syahrilTGR/KatroKit_esp32/image/fisik_loadCell&HCSR.jpeg

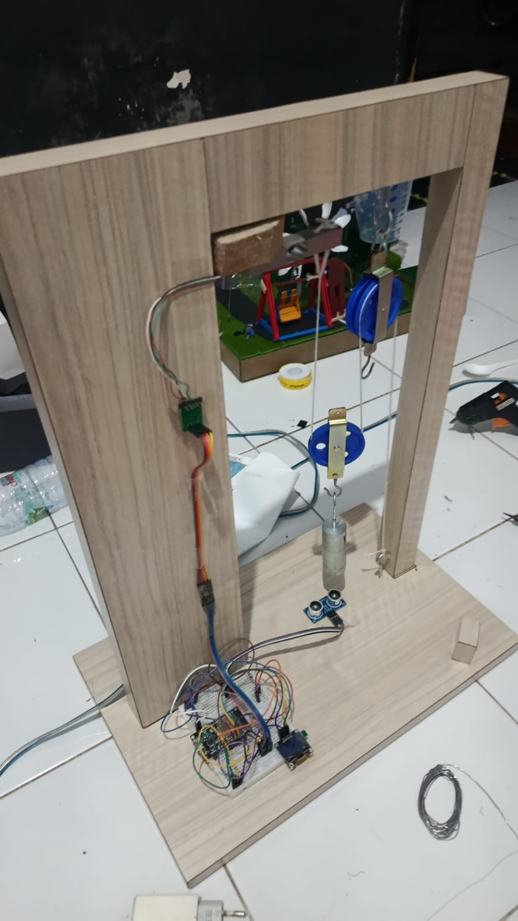
image/fisik_loadCell&HCSR.jpeg
