syahrilTGR/KatroKit_esp32/image/loadCell&HCSR.jpeg

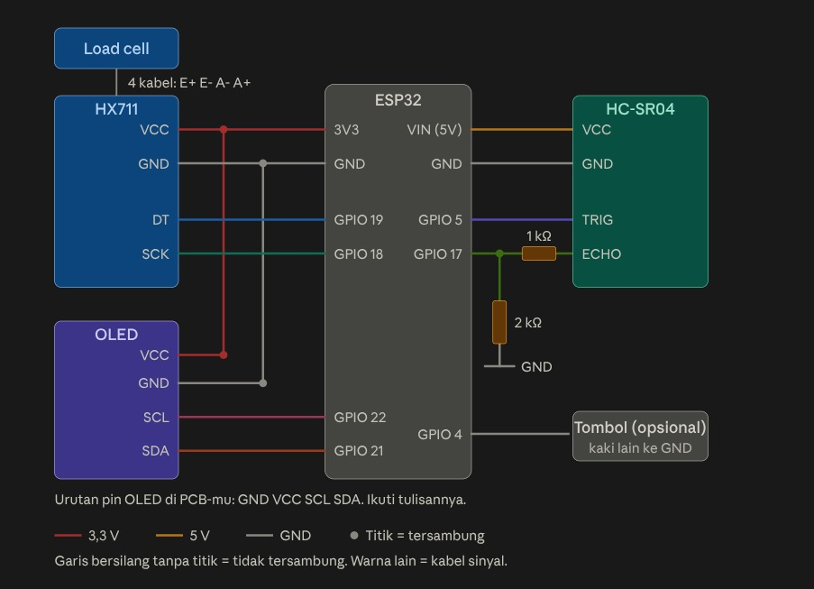
image/loadCell&HCSR.jpeg
