syahrilTGR/KatroKit_esp32/(list of files, cad)

Other CAD files:
docs/acrylic_box_cutting.dxf
docs/hcsr04_casing_cutting.dxf
