syahrilTGR/KatroKit_esp32/arduino/KatroKit_esp32/KatroKit_esp32.ino

/*
  KatroKit - ESP32  v2  (tanpa laptop / tanpa Serial Monitor)
  Load cell + HX711 (gaya tarik), HC-SR04 (jarak/perpindahan), OLED SSD1306 I2C 0.96"

  PIN KONEKTOR JST-XH (PCB Matrix):
    HX711   : Pin 1:VCC(3.3V), Pin 2:SCK(GPIO 18), Pin 3:DT(GPIO 19), Pin 4:GND
    HC-SR04 : Pin 1:VCC(5V), Pin 2:TRIG(GPIO 5), Pin 3:ECHO(GPIO 17 via Divider 1k/2k), Pin 4:GND
    OLED    : Pin 1:GND, Pin 2:VCC(3.3V), Pin 3:SCL(GPIO 22), Pin 4:SDA(GPIO 21)
    Tombol  : Push button eksternal box akrilik (soket JST GPIO 4)

  SATU TOMBOL, BEBERAPA AKSI (tahan lalu LEPAS; layar menunjukkan aksinya):
    < 1,5 dtk   -> TARE gaya + nol-kan jarak
    1,5 - 3 dtk -> TIMBANG W   (beban digantung langsung di load cell)
    3 - 5 dtk   -> PILIH W     (ganti W ke preset berikutnya: 100/200/250/300/500 g)
    > 5 dtk     -> KALIBRASI   (pakai beban referensi CAL_REF_G, default 200 g)

  URUTAN PAKAI PERTAMA KALI (tanpa laptop):
    1. Kait kosong -> tekan singkat (TARE).
    2. Gantung beban 200 g di load cell, diam -> tahan BOOT > 5 dtk, lepas (KALIBRASI).
    3. Kait kosong -> TARE lagi. Alat siap.
    4. Pilih W: timbang (1,5-3 dtk) ATAU pilih preset (3-5 dtk).
    5. Pasang beban di katrol -> TARE -> tarik.

  Perintah Serial Monitor tetap ada (opsional):
    t z r i d m | c<gram> | c0 | b<gram>
*/

#include <Arduino.h>
#include <Wire.h>
#include <Adafruit_GFX.h>
#include <Adafruit_SSD1306.h>
#include <HX711.h>
#include <Preferences.h>
#include <WiFi.h>
#include <WiFiManager.h>
#include <ArduinoOTA.h>
#include <PubSubClient.h>
#include <ArduinoJson.h>

// ---------- Pin ----------
const int HX_DT   = 19;
const int HX_SCK  = 18;
const int TRIG    = 5;
const int ECHO    = 17;
const int SDA_PIN = 21;
const int SCL_PIN = 22;
const int BTN     = 4;   // tombol push button eksternal (soket JST GPIO 4)

// ---------- Pengaturan ----------
const float CAL_REF_G = 240.0f;                       // beban referensi kalibrasi 1-titik (gram)
const float PRESETS[] = {50, 100, 120, 140, 200, 240}; // pilihan W lewat tombol (gram)
const int   N_PRESETS = 6;

const unsigned long T_WEIGH  = 1500;   // batas tahan: tare -> timbang
const unsigned long T_PRESET = 3000;   // timbang -> pilih W
const unsigned long T_CAL    = 5000;   // pilih W -> kalibrasi

// ---------- OLED ----------
const int SCREEN_W = 128;
const int SCREEN_H = 64;
const uint8_t OLED_ADDR = 0x3C;   // jika layar kosong, coba 0x3D
Adafruit_SSD1306 display(SCREEN_W, SCREEN_H, &Wire, -1);
bool oledOk = false;

// ---------- WiFiManager & ArduinoOTA (Non-Blocking Asinkron) ----------
WiFiManager wm;
bool otaStarted = false;
bool apStarted = false;

enum WiFiState {
  WIFI_CONNECTING,      // Sedang mencoba koneksi router di background (max 15 detik)
  WIFI_HOTSPOT_NOTIF,   // Hotspot aktif, tampilkan notifikasi di OLED selama 1 detik
  WIFI_CONNECTED_NOTIF, // WiFi terhubung, tampilkan notifikasi di OLED selama 1 detik
  WIFI_RUNNING          // Hotspot / WiFi aktif di background, OLED normal
};

WiFiState wifiState = WIFI_CONNECTING;
unsigned long wifiStartTime = 0;
unsigned long wifiNotifStart = 0;

// ---------- MQTT & Security Token (HiveMQ Public) ----------
const char* MQTT_BROKER    = "broker.hivemq.com";
const int   MQTT_PORT      = 1883;
String      deviceId       = "katrokit_01";
String      secretToken    = "katrokit2026";
String      topicTelemetry = "katrokit/katrokit_01/telemetry";
String      topicCmd       = "katrokit/katrokit_01/cmd";

WiFiClient espClient;
PubSubClient mqttClient(espClient);
unsigned long lastMqttReconnect = 0;
unsigned long lastMqttPublish   = 0;

// Flag sinkronisasi antar-Core (Thread-safe)
volatile bool remoteTareReq     = false;
volatile bool remoteZeroDistReq = false;
volatile bool remoteResetMaxReq = false;
volatile int  remoteModeReq     = -1;
volatile bool remoteNextModeReq = false;
TaskHandle_t mqttTaskHandle     = NULL;

// ---------- Mode Jenis Katrol (Teori vs Media) ----------
enum PulleyMode {
  MODE_TETAP = 0,   // Katrol Tetap: Load cell menahan poros (W + F = 2F) -> F_kuasa = F_sensor / 2
  MODE_BEBAS = 1,   // Katrol Bebas: Load cell menahan 1 helai tali jangkar -> F_kuasa = F_sensor
  MODE_MAJEMUK = 2  // Katrol Majemuk: Load cell menahan 1 helai tali jangkar -> F_kuasa = F_sensor
};

PulleyMode pulleyMode = MODE_TETAP;
const char* PULLEY_NAMES[] = {"KATROL TETAP", "KATROL BEBAS", "KATROL MAJEMUK"};
const char* PULLEY_SHORT[] = {"TETAP", "BEBAS", "MAJEMUK"};
const float PULLEY_KM_THEORY[] = {1.0f, 2.0f, 2.0f};

// ---------- HX711 & Kalibrasi ----------
HX711 scale;
Preferences prefs;
const float G = 9.81f;
float calFactor = 1.0f;
float forceSign = -1.0f;

// Kalibrasi 2-Segmen (Multi-Point)
bool isMultiCal = false;
float cal1 = 1.0f;
float cal2 = 1.0f;
float midGrams = 100.0f;
long midRaw = 0;

// Konversi RAW ADC ke Newton & Gram
float rawToNewtons(float raw) {
  float raw_adj = forceSign * raw;
  if (isMultiCal && midRaw > 0 && cal1 > 0 && cal2 > 0) {
    float grams = 0.0f;
    if (raw_adj <= (float)midRaw) {
      grams = raw_adj / cal1;
    } else {
      grams = midGrams + ((raw_adj - (float)midRaw) / cal2);
    }
    return (grams / 1000.0f) * G;
  }
  return raw_adj / calFactor;
}

float rawToGrams(float raw) {
  return (rawToNewtons(raw) / G) * 1000.0f;
}

// ---------- Filter ----------
const int F_N = 3;
float fBuf[F_N];
int fIdx = 0;
bool fFull = false;
long lastRaw = 0;
float force = 0, forceMax = 0, usaha = 0, fSensor = 0;
float bebanGram = 500.0f;
float bebanW = 0.0f;
float km = 0.0f;
bool isCalibrated = false;

const int D_N = 3;
float dBuf[D_N];
int dIdx = 0;
bool dFull = false;
float distCm = 0;
float distRef = 3.0f;
bool distValid = false;

unsigned long lastDist = 0, lastDraw = 0;

// ---------- Tombol ----------
bool btnDown = false;
unsigned long btnDownAt = 0;
unsigned long lastClickReleaseAt = 0;
int clickCount = 0;
bool waitingForMultiClick = false;
const unsigned long MULTI_CLICK_WINDOW_MS = 380;

// ---------- Timbang beban ----------
const float WEIGH_MIN_G    = 20.0f;
const float WEIGH_MAX_G    = 1000.0f;
const float WEIGH_STABLE_N = 0.08f;
const int   SAMPLES        = 20;

// ---------- Fungsi bantu ----------
float avgBuf(float *buf, int n, bool full, int idx) {
  int cnt = full ? n : idx;
  if (cnt == 0) return 0;
  float s = 0;
  for (int i = 0; i < cnt; i++) s += buf[i];
  return s / cnt;
}

float readDistanceCm() {
  digitalWrite(TRIG, LOW);
  delayMicroseconds(2);
  digitalWrite(TRIG, HIGH);
  delayMicroseconds(10);
  digitalWrite(TRIG, LOW);
  unsigned long dur = pulseIn(ECHO, HIGH, 15000UL);
  if (dur == 0) return -1;
  return dur * 0.0343f / 2.0f;
}

bool hxReady() {
  if (scale.wait_ready_timeout(1000)) return true;
  Serial.println("HX711 tidak merespons! Cek DT/SCK, VCC 3.3V dan GND.");
  return false;
}

// Pesan 3 baris di OLED + tahan sebentar
void showMsg(const char *l1, const char *l2 = "", const char *l3 = "", int holdMs = 0) {
  if (oledOk) {
    display.clearDisplay();
    display.setTextColor(SSD1306_WHITE);
    display.setTextSize(1);
    display.setCursor(0, 8);  display.print(l1);
    display.setCursor(0, 26); display.print(l2);
    display.setCursor(0, 44); display.print(l3);
    display.display();
  }
  if (holdMs > 0) delay(holdMs);
}

// Ambil SAMPLES bacaan mentah (sudah dikurangi tare). true jika cukup data.
bool sampleRaw(float &mean, float &spread) {
  float sum = 0, mn = 1e12f, mx = -1e12f;
  int got = 0;
  unsigned long t0 = millis();
  while (got < SAMPLES && millis() - t0 < 4000) {
    if (scale.is_ready()) {
      float r = (float)scale.get_value(1);
      sum += r;
      if (r < mn) mn = r;
      if (r > mx) mx = r;
      got++;
    }
  }
  if (got < SAMPLES) return false;
  mean = sum / got;
  spread = mx - mn;
  return true;
}

void tareForce() {
  if (!hxReady()) return;
  scale.tare(10);
  fIdx = 0; fFull = false;
  force = 0; forceMax = 0; km = 0; usaha = 0;
  Serial.println("Tare selesai.");
}

void zeroDistance(bool showPopup = true) {
  if (!distValid) {
    float d = readDistanceCm();
    if (d > 2.0f && d < 250.0f) {
      distCm = d;
      distValid = true;
    }
  }
  if (distValid) {
    distRef = distCm;
    prefs.putFloat("dist_ref", distRef);
    usaha = 0;
    Serial.printf("[DIST] Referensi jarak (0 cm) diset ke: %.1f cm (tersimpan di Flash)\n", distRef);
    if (showPopup) {
      char b1[24];
      snprintf(b1, sizeof(b1), "Titik 0 = %.1f cm", distRef);
      showMsg("JARAK DI-NOL-KAN", b1, "[Tersimpan di Flash]", 1200);
    }
  } else {
    Serial.println("[DIST] Gagal set distRef: sensor HC-SR04 belum valid.");
    if (showPopup) {
      showMsg("JARAK ERROR", "Cek sensor HC-SR04", "", 1200);
    }
  }
}

void resetCalibration() {
  calFactor = 1.0f;
  isMultiCal = false;
  prefs.putBool("is_multi", false);
  prefs.putFloat("cal", 1.0f);
  isCalibrated = false;
  Serial.println("Kalibrasi di-reset (!CAL).");
}

// Kalibrasi dengan beban referensi yang SEDANG menggantung di load cell
// (load cell sudah di-tare saat kosong).
void calibrate(float grams) {
  if (grams > 1000.0f) {
    Serial.println("Kapasitas load cell 1 kg! Pakai beban referensi <= 1000 g.");
    showMsg("MELEBIHI 1 KG", "Pakai beban <= 1kg", "", 1800);
    return;
  }
  if (!hxReady()) return;

  char b1[24];
  snprintf(b1, sizeof(b1), "Referensi %.0f g", grams);
  showMsg("KALIBRASI...", b1, "Jaga beban diam");
  Serial.println("Kalibrasi dimulai... beban harus menggantung diam.");
  delay(800);

  float raw, spread;
  if (!sampleRaw(raw, spread)) {
    showMsg("GAGAL", "HX711 lambat/putus", "", 1800);
    return;
  }
  if (fabs(raw) < 50.0f) {
    Serial.println("Gagal: tidak ada beban terdeteksi. Tare dulu saat kosong, lalu gantung beban.");
    showMsg("BEBAN TAK TERBACA", "TARE saat kosong,", "lalu gantung beban", 2200);
    return;
  }
  if (spread > 0.05f * fabs(raw)) {
    Serial.println("Gagal: beban belum diam.");
    showMsg("BEBAN GOYANG", "Tunggu diam lalu", "ulangi kalibrasi", 2000);
    return;
  }

  float newton = (grams / 1000.0f) * G;
  forceSign = (raw < 0) ? -1.0f : 1.0f;
  prefs.putFloat("sign", forceSign);
  calFactor = fabs(raw) / newton;
  prefs.putFloat("cal", calFactor);
  isMultiCal = false;
  prefs.putBool("is_multi", false);
  fIdx = 0; fFull = false; forceMax = 0;
  isCalibrated = true;

  Serial.println("=== KALIBRASI SUKSES ===");
  Serial.print("Massa referensi: "); Serial.print(grams, 1); Serial.println(" g");
  Serial.print("Nilai RAW ADC  : "); Serial.println(raw, 0);
  Serial.print("Faktor Skala   : "); Serial.println(calFactor, 2);
  Serial.print("Arah Gaya      : "); Serial.println(forceSign > 0 ? "Normal (+)" : "Dibalik (-)");

  showMsg("KALIBRASI OK", b1, "Kait kosong -> TARE", 2500);
}

// Kalibrasi 2-Segmen (0g -> Tengah -> Maksimal)
void calibrateMulti() {
  Serial.println("\n========================================================");
  Serial.println("  KALIBRASI 2-SEGMEN (MULTI-POINT: 0g -> TENGAH -> MAX) ");
  Serial.println("========================================================");
  Serial.println("Panduan beban yang Anda miliki (50gx4, 20gx2):");
  Serial.println("  * Beban Tengah  : misal 100g (2x 50g) atau 120g (2x 50g + 1x 20g)");
  Serial.println("  * Beban Maksimal: 240g (semua beban dipasang)");
  Serial.println("--------------------------------------------------------");

  showMsg("KALIBRASI MULTI", "Langkah 1/3", "Kait kosong -> Enter", 1000);

  // Langkah 1: Tare titik nol
  Serial.println("\n[LANGKAH 1/3] KOSONGKAN KAIT (0 gram).");
  Serial.println(">> Ketik sembarang karakter lalu Enter setelah kait kosong:");
  while (true) {
    if (Serial.available()) {
      String s = Serial.readStringUntil('\n');
      s.trim();
      if (s.length() > 0) break;
    }
    delay(50);
  }
  Serial.print(">> Mengunci titik nol (Tare 20 sampel)... ");
  scale.tare(20);
  fIdx = 0; fFull = false; forceMax = 0;
  Serial.println("SUKSES (Titik 0g terkunci).");

  showMsg("LANGKAH 2/3", "Gantung Beban Mid", "Ketik gram di Serial", 1000);

  // Langkah 2: Beban Tengah
  Serial.println("\n[LANGKAH 2/3] GANTUNG BEBAN TENGAH (misal 100g atau 120g).");
  Serial.println(">> Masukkan angka berat dalam gram (contoh: 100):");
  float wMid = 0;
  while (wMid <= 0) {
    if (Serial.available()) {
      String s = Serial.readStringUntil('\n');
      s.trim();
      wMid = s.toFloat();
      if (wMid <= 0) {
        Serial.println(">> Angka tidak valid. Masukkan angka (misal 100):");
      }
    }
    delay(50);
  }
  Serial.printf(">> Beban tengah: %.1f g. Mengambil 20 sampel stabil...\n", wMid);
  delay(1500);

  float rawMidF = 0, spreadMid = 0;
  if (!sampleRaw(rawMidF, spreadMid)) {
    Serial.println("[GAGAL] HX711 tidak merespons atau beban goyang.");
    showMsg("GAGAL", "HX711 lambat/goyang", "", 1800);
    return;
  }
  long adjMid = labs((long)rawMidF);
  if (adjMid < 50) {
    Serial.println("[GAGAL] Nilai ADC terlalu kecil. Periksa gantungan beban!");
    showMsg("BEBAN TAK TERBACA", "Periksa beban", "", 2000);
    return;
  }
  float c1 = (float)adjMid / wMid;
  Serial.printf(">> Titik Tengah OK! ADC: %ld | cal1: %.2f\n", (long)rawMidF, c1);

  showMsg("LANGKAH 3/3", "Gantung Beban Max", "Ketik gram di Serial", 1000);

  // Langkah 3: Beban Maksimal
  Serial.println("\n[LANGKAH 3/3] GANTUNG BEBAN MAKSIMAL (contoh: 240g).");
  Serial.println(">> Masukkan angka berat maksimal dalam gram (contoh: 240):");
  float wMax = 0;
  while (wMax <= wMid) {
    if (Serial.available()) {
      String s = Serial.readStringUntil('\n');
      s.trim();
      wMax = s.toFloat();
      if (wMax <= wMid) {
        Serial.printf(">> Beban maksimal harus lebih besar dari %.1f g (contoh: 240):\n", wMid);
      }
    }
    delay(50);
  }
  Serial.printf(">> Beban maksimal: %.1f g. Mengambil 20 sampel stabil...\n", wMax);
  delay(1500);

  float rawMaxF = 0, spreadMax = 0;
  if (!sampleRaw(rawMaxF, spreadMax)) {
    Serial.println("[GAGAL] HX711 tidak merespons atau beban goyang.");
    showMsg("GAGAL", "HX711 lambat/goyang", "", 1800);
    return;
  }
  long adjMax = labs((long)rawMaxF);
  if (adjMax <= adjMid + 50) {
    Serial.println("[GAGAL] Nilai ADC maksimal tidak bertambah secara wajar.");
    showMsg("GAGAL", "ADC tdk bertambah", "", 2000);
    return;
  }
  float c2 = (float)(adjMax - adjMid) / (wMax - wMid);
  Serial.printf(">> Titik Maksimal OK! ADC: %ld | cal2: %.2f\n", (long)rawMaxF, c2);

  // Hitung polaritas arah
  forceSign = (rawMaxF < 0) ? -1.0f : 1.0f;

  // Simpan data Multi-Segmen
  isMultiCal = true;
  cal1 = c1;
  cal2 = c2;
  midGrams = wMid;
  midRaw = adjMid;
  calFactor = ((float)adjMax / (wMax / 1000.0f)) / G;
  isCalibrated = true;

  prefs.putBool("is_multi", true);
  prefs.putFloat("cal1", cal1);
  prefs.putFloat("cal2", cal2);
  prefs.putFloat("mid_w", midGrams);
  prefs.putLong("mid_raw", midRaw);
  prefs.putFloat("cal", calFactor);
  prefs.putFloat("sign", forceSign);

  Serial.println("\n========================================================");
  Serial.println(">> KALIBRASI 2-SEGMEN BERHASIL DISIMPAN KE FLASH ESP32!");
  Serial.printf("   Segmen 1 (0 s/d %.0f g)    : cal1 = %.2f\n", midGrams, cal1);
  Serial.printf("   Segmen 2 (%.0f s/d %.0f g) : cal2 = %.2f\n", midGrams, wMax, cal2);
  Serial.printf("   Arah Tanda (Sign)         : %.1f\n", forceSign);
  Serial.println(">> Sekarang beban tengah maupun beban maksimal akan presisi!");
  Serial.println("========================================================\n");

  showMsg("KALIBRASI MULTI OK", "Tersimpan di Flash", "Alat siap digunakan", 2500);
}

// Menunggu klik tombol D4 (debounce + non-blocking OTA/WiFi)
bool waitForButtonClick(unsigned long timeoutMs = 30000) {
  unsigned long start = millis();
  // Tunggu tombol dilepas jika masih tertahan
  while (digitalRead(BTN) == LOW) {
    delay(10);
    if (millis() - start > timeoutMs) return false;
  }
  delay(80);

  // Tunggu ditekan (LOW)
  while (digitalRead(BTN) == HIGH) {
    delay(10);
    wm.process();
    if (WiFi.status() == WL_CONNECTED) ArduinoOTA.handle();
    if (millis() - start > timeoutMs) return false;
  }
  delay(50);

  // Tunggu dilepas (HIGH)
  while (digitalRead(BTN) == LOW) {
    delay(10);
    if (millis() - start > timeoutMs) return false;
  }
  delay(80);
  return true;
}

// Wizard Kalibrasi 2-Titik (0g -> 100g -> 240g) dipandu Layar OLED + Tombol D4
void calibrateMultiOLED() {
  Serial.println("\n[KALIBRASI] Memulai Wizard Kalibrasi 2-Titik via Tombol D4...");

  // Konfirmasi Awal (Timeout 5s untuk mencegah salah tekan)
  display.clearDisplay();
  display.setTextColor(SSD1306_WHITE);
  display.setTextSize(1);
  display.setCursor(0, 0);
  display.println("KALIBRASI 2-TITIK");
  display.setCursor(0, 16);
  display.println("Klik D4 utk MULAI");
  display.setCursor(0, 32);
  display.println("atau DIAMKAN 5 dtk");
  display.setCursor(0, 48);
  display.println("untuk BATAL...");
  display.display();

  if (!waitForButtonClick(5000)) {
    Serial.println("[KALIBRASI] Dibatalkan oleh pengguna (timeout 5s).");
    showMsg("KALIBRASI BATAL", "Kembali ke menu", "", 1200);
    return;
  }

  // --- LANGKAH 1: TITIK NOL (KAIT KOSONG) ---
  display.clearDisplay();
  display.setTextSize(1);
  display.setCursor(0, 0);
  display.println("KALIBRASI (1/3)");
  display.setCursor(0, 18);
  display.println("Kait KOSONG (0 g)");
  display.setCursor(0, 36);
  display.println("Jangan sentuh tali!");
  display.setCursor(0, 52);
  display.println("-> Klik D4 jika siap");
  display.display();

  if (!waitForButtonClick(30000)) {
    showMsg("BATAL (TIMEOUT)", "Waktu habis", "", 1500);
    return;
  }

  showMsg("MEMPROSES...", "Mengunci Titik 0g", "Mohon tunggu...", 0);
  delay(500);
  scale.tare(20);
  fIdx = 0; fFull = false; forceMax = 0;
  Serial.println("[OK] Titik 0 g berhasil dikunci (Tare).");

  // --- LANGKAH 2: TITIK TENGAH (100 g) ---
  display.clearDisplay();
  display.setTextSize(1);
  display.setCursor(0, 0);
  display.println("KALIBRASI (2/3)");
  display.setCursor(0, 18);
  display.println("Gantung 100g (2x50g)");
  display.setCursor(0, 36);
  display.println("Pastikan beban diam");
  display.setCursor(0, 52);
  display.println("-> Klik D4 jika diam");
  display.display();

  if (!waitForButtonClick(30000)) {
    showMsg("BATAL (TIMEOUT)", "Waktu habis", "", 1500);
    return;
  }

  showMsg("MEMPROSES...", "Membaca 100 g...", "Mohon tunggu...", 0);
  delay(1200);

  float rawMidF = 0, spreadMid = 0;
  if (!sampleRaw(rawMidF, spreadMid)) {
    showMsg("GAGAL!", "Beban goyang/lepas", "Ulangi kalibrasi", 2000);
    return;
  }
  long adjMid = labs((long)rawMidF);
  if (adjMid < 50) {
    showMsg("BEBAN TAK TERBACA", "Periksa gantungan", "", 2000);
    return;
  }
  float c1 = (float)adjMid / 100.0f;
  Serial.printf("[OK] Titik 100g terbaca: ADC=%ld, cal1=%.2f\n", (long)rawMidF, c1);

  // --- LANGKAH 3: TITIK MAKSIMAL (240 g) ---
  display.clearDisplay();
  display.setTextSize(1);
  display.setCursor(0, 0);
  display.println("KALIBRASI (3/3)");
  display.setCursor(0, 18);
  display.println("Gantung 240g (Semua)");
  display.setCursor(0, 36);
  display.println("Pastikan beban diam");
  display.setCursor(0, 52);
  display.println("-> Klik D4 jika diam");
  display.display();

  if (!waitForButtonClick(30000)) {
    showMsg("BATAL (TIMEOUT)", "Waktu habis", "", 1500);
    return;
  }

  showMsg("MEMPROSES...", "Membaca 240 g...", "Mohon tunggu...", 0);
  delay(1200);

  float rawMaxF = 0, spreadMax = 0;
  if (!sampleRaw(rawMaxF, spreadMax)) {
    showMsg("GAGAL!", "Beban goyang/lepas", "Ulangi kalibrasi", 2000);
    return;
  }
  long adjMax = labs((long)rawMaxF);
  if (adjMax <= adjMid + 50) {
    showMsg("GAGAL!", "ADC tidak bertambah", "Cek berat beban", 2000);
    return;
  }
  float c2 = (float)(adjMax - adjMid) / (240.0f - 100.0f);
  forceSign = (rawMaxF < 0) ? -1.0f : 1.0f;

  // Simpan hasil kalibrasi ke Flash (NVS Preferences)
  isMultiCal = true;
  cal1 = c1;
  cal2 = c2;
  midGrams = 100.0f;
  midRaw = adjMid;
  calFactor = ((float)adjMax / (240.0f / 1000.0f)) / G;
  isCalibrated = true;

  prefs.putBool("is_multi", true);
  prefs.putFloat("cal1", cal1);
  prefs.putFloat("cal2", cal2);
  prefs.putFloat("mid_w", midGrams);
  prefs.putLong("mid_raw", midRaw);
  prefs.putFloat("cal", calFactor);
  prefs.putFloat("sign", forceSign);

  Serial.println("\n[SUKSES] Kalibrasi 2-Titik via Tombol D4 berhasil disimpan!");
  Serial.printf("         cal1 = %.2f | cal2 = %.2f | Arah = %.1f\n", cal1, cal2, forceSign);

  display.clearDisplay();
  display.setTextSize(1);
  display.setCursor(0, 0);
  display.println("KALIBRASI SUKSES!");
  display.setCursor(0, 16);
  display.printf("c1:%.1f  c2:%.1f\n", cal1, cal2);
  display.setCursor(0, 32);
  display.println("Disimpan ke Flash");
  display.setCursor(0, 48);
  display.println("Alat Siap Digunakan!");
  display.display();
  delay(2500);
}

void setBeban(float grams) {
  bebanGram = grams;
  bebanW = (bebanGram / 1000.0f) * G;
  prefs.putFloat("beban", bebanGram);
}

// Timbang beban yang menggantung langsung di load cell -> simpan sebagai W
void weighLoad() {
  if (!isCalibrated) {
    Serial.println("Timbang gagal: belum dikalibrasi.");
    showMsg("BELUM KALIBRASI", "Tahan BOOT >5 dtk", "dgn beban 200 g", 2500);
    return;
  }
  if (!hxReady()) return;

  showMsg("Menimbang beban...", "Jaga beban diam");
  delay(800);

  float raw, spread;
  if (!sampleRaw(raw, spread)) {
    showMsg("GAGAL", "HX711 lambat/putus", "", 1800);
    return;
  }
  float newton = rawToNewtons(raw);
  float grams = rawToGrams(raw);
  float spreadN = (spread / 1000.0f) * G / (isMultiCal ? cal1 : calFactor);

  if (spreadN > WEIGH_STABLE_N) {
    showMsg("BEBAN GOYANG", "Tunggu diam lalu", "ulangi timbang", 2000);
    return;
  }
  if (grams < WEIGH_MIN_G) {
    Serial.print("Terbaca hanya "); Serial.print(grams, 0); Serial.println(" g");
    char b2[24];
    snprintf(b2, sizeof(b2), "Terbaca %.0f g", grams);
    showMsg("BEBAN TAK TERBACA", b2, "Tare saat kosong?", 2500);
    return;
  }
  if (grams > WEIGH_MAX_G) {
    showMsg("MELEBIHI 1 KG", "Turunkan beban!", "", 1800);
    return;
  }

  setBeban(grams);
  char b1[24], b2[24];
  snprintf(b1, sizeof(b1), "W = %.0f g", bebanGram);
  snprintf(b2, sizeof(b2), "= %.2f N", bebanW);
  Serial.print("W terbaca: "); Serial.print(bebanGram, 0); Serial.println(" g (tersimpan)");
  showMsg("BEBAN TERSIMPAN", b1, b2, 2200);
}

// Ganti W ke preset berikutnya (untuk kasus beban tidak bisa digantung di load cell)
void nextPreset() {
  int cur = -1;
  for (int i = 0; i < N_PRESETS; i++) if (fabs(PRESETS[i] - bebanGram) < 1.0f) cur = i;
  int nxt = (cur + 1) % N_PRESETS;
  setBeban(PRESETS[nxt]);
  char b1[24], b2[24];
  snprintf(b1, sizeof(b1), "W = %.0f g", bebanGram);
  snprintf(b2, sizeof(b2), "= %.2f N", bebanW);
  Serial.print("W preset: "); Serial.print(bebanGram, 0); Serial.println(" g");
  showMsg("W DIGANTI (PRESET)", b1, b2, 1500);
}

void printDiagnostics() {
  if (!hxReady()) return;
  float rawVal = scale.get_value(5);
  Serial.println("--- DIAGNOSTIK SENSOR HX711 ---");
  Serial.print("Nilai RAW ADC saat ini : "); Serial.println(rawVal, 0);
  if (isMultiCal) {
    Serial.println("Mode Kalibrasi         : 2-SEGMEN (MULTI-POINT)");
    Serial.printf("Segmen 1 (0 -> %.0fg)   : cal1 = %.2f\n", midGrams, cal1);
    Serial.printf("Segmen 2 (%.0fg -> MAX): cal2 = %.2f\n", midGrams, cal2);
  } else {
    Serial.println("Mode Kalibrasi         : 1-TITIK STANDAR");
    Serial.print("Faktor Kalibrasi       : "); Serial.println(calFactor, 2);
  }
  Serial.print("Status Kalibrasi       : "); Serial.println(isCalibrated ? "TERKALIBRASI (OK)" : "BELUM (!CAL)");
  Serial.print("Arah Tanda (Sign)      : "); Serial.println(forceSign > 0 ? "+1.0 (Normal)" : "-1.0 (Inverted)");
  Serial.print("Pembacaan Gaya (N)     : "); Serial.println(force, 2);
  Serial.print("Beban W                : "); Serial.print(bebanGram, 0); Serial.println(" g");
  Serial.println("-------------------------------");
}

void setPulleyMode(PulleyMode mode, bool showPopup = true) {
  pulleyMode = mode;
  prefs.putUChar("pulley_mode", (uint8_t)pulleyMode);
  Serial.printf("[MODE] Mode Katrol diubah ke: %s (Teori KM: %.1f)\n", PULLEY_NAMES[pulleyMode], PULLEY_KM_THEORY[pulleyMode]);

  if (showPopup && oledOk) {
    display.clearDisplay();
    display.setTextColor(SSD1306_WHITE);
    display.setTextSize(1);
    display.setCursor(12, 6);
    display.println("GANTI MODE KATROL");
    display.drawFastHLine(0, 18, 128, SSD1306_WHITE);

    display.setCursor(14, 25);
    display.println(PULLEY_NAMES[pulleyMode]);

    display.setCursor(20, 39);
    display.printf("Teori KM = %.1f\n", PULLEY_KM_THEORY[pulleyMode]);

    display.setCursor(10, 53);
    display.println("[Tersimpan di Flash]");
    display.display();
    delay(1200);
    lastDraw = millis();
  }
}

void nextPulleyMode() {
  int next = ((int)pulleyMode + 1) % 3;
  setPulleyMode((PulleyMode)next, true);
}

void handleSerial() {
  if (!Serial.available()) return;
  String s = Serial.readStringUntil('\n');
  s.trim();
  s.toLowerCase();
  if (s.length() == 0) return;
  char c = s.charAt(0);
  String arg = s.substring(1);

  if (c == 'k') nextPulleyMode();

  if (c == 't') tareForce();
  else if (c == 'z') zeroDistance();
  else if (c == 'r') { forceMax = 0; Serial.println("Maks direset."); }
  else if (c == 'i') {
    forceSign = -forceSign;
    prefs.putFloat("sign", forceSign);
    Serial.println(forceSign > 0 ? "Arah: Normal (+)" : "Arah: Dibalik (-)");
  }
  else if (c == 'd') printDiagnostics();
  else if (s == "m" || s == "mcal") calibrateMulti();
  else if (s == "w" || s == "weigh") weighLoad();
  else if (c == 'c') {
    if (arg == "0") resetCalibration();
    else if (arg.toFloat() > 0) calibrate(arg.toFloat());
    else Serial.println("Format salah. Contoh: c240 atau c0");
  }
  else if (c == 'b') {
    float bg = arg.toFloat();
    if (bg > 0) {
      setBeban(bg);
      Serial.print("Beban W diatur: "); Serial.print(bebanGram, 1); Serial.println(" g");
    } else {
      Serial.println("Massa beban tidak valid. Contoh: b240");
    }
  }
  else Serial.println("Perintah: t (tare) | z (zero dist) | m (multi-cal) | w (timbang) | i (invert) | d (diag) | c<g> | b<g>");
}

// Layar saat tombol ditahan: tunjukkan aksi yang terjadi jika dilepas sekarang
void drawHold(unsigned long held) {
  if (!oledOk) return;
  const char *act;
  if (held < T_WEIGH)       act = "TARE";
  else if (held < T_PRESET) act = "TIMBANG W";
  else if (held < T_CAL)    act = "PILIH W";
  else                      act = "KALIBRASI";

  display.clearDisplay();
  display.setTextColor(SSD1306_WHITE);
  display.setTextSize(1);
  display.setCursor(0, 0);  display.print("Tombol ditahan");
  display.setCursor(0, 12); display.print("Lepas sekarang =");
  display.setTextSize(2);
  display.setCursor(0, 26); display.print(act);
  display.setTextSize(1);
  display.setCursor(0, 56); display.print(held / 1000.0f, 1); display.print(" dtk");
  unsigned long h = held > T_CAL ? T_CAL : held;
  int w = (int)((h * 128UL) / T_CAL);
  display.fillRect(0, 48, w, 5, SSD1306_WHITE);
  display.display();
}

void draw() {
  if (!oledOk) return;
  display.clearDisplay();
  display.setTextColor(SSD1306_WHITE);

  // === ZONA ATAS: F (Kuasa) & W (Beban) ===
  display.setTextSize(1);
  display.setCursor(2, 0);
  display.print("F(Kuasa)");
  display.setCursor(68, 0);
  display.print("W(Beban)");

  display.setCursor(2, 10);
  if (!isCalibrated) {
    display.print("!CAL");
  } else if (fabs(force) > 9.99f) {
    display.print("OVLD");
  } else {
    display.print(force, 2);
    display.print("N");
  }

  display.setCursor(68, 10);
  display.print(bebanW, 2);
  display.print("N");

  display.drawFastHLine(0, 20, 128, SSD1306_WHITE);

  // === ZONA TENGAH: KM = W / F ===
  display.setTextSize(1);
  char modeStr[32];
  snprintf(modeStr, sizeof(modeStr), "[%s] KM=W/F", PULLEY_SHORT[pulleyMode]);
  int textW = strlen(modeStr) * 6;
  int startX = (128 - textW) / 2;
  if (startX < 0) startX = 0;
  display.setCursor(startX, 23);
  display.print(modeStr);

  display.setTextSize(2);
  display.setCursor(40, 33);
  if (!isCalibrated || force < 0.30f) {
    display.print("---");
  } else if (km >= 10.0f) {
    display.print(">10");
  } else {
    display.print(km, 2);
  }

  display.drawFastHLine(0, 50, 128, SSD1306_WHITE);

  // === ZONA BAWAH: d, s, U ===
  display.setTextSize(1);
  display.setCursor(0, 54);
  display.print("d:");
  if (distValid) { display.print(distCm, 0); display.print("cm"); }
  else display.print("---");

  display.setCursor(43, 54);
  display.print("s:");
  if (distValid) { display.print(fabs(distCm - distRef), 0); display.print("cm"); }
  else display.print("---");

  display.setCursor(86, 54);
  display.print("U:");
  if (isCalibrated) {
    if (usaha > 99.9f) display.print(">99J");
    else { display.print(usaha, 1); display.print("J"); }
  } else {
    display.print("---");
  }

  display.display();
}

// Setup dan Handler ArduinoOTA
void setupOTA() {
  ArduinoOTA.setHostname("katrokit-esp32");

  ArduinoOTA.onStart([]() {
    String type;
    if (ArduinoOTA.getCommand() == U_FLASH) {
      type = "sketch";
    } else {
      type = "filesystem";
    }
    Serial.println("\n[OTA] Mulai update firmware: " + type);
    if (oledOk) {
      display.clearDisplay();
      display.setTextColor(SSD1306_WHITE);
      display.setTextSize(1);
      display.setCursor(0, 15);
      display.println("OTA UPDATE...");
      display.setCursor(0, 35);
      display.println("Mohon Tunggu...");
      display.display();
    }
  });

  ArduinoOTA.onEnd([]() {
    Serial.println("\n[OTA] Update Selesai & Berhasil! Restarting...");
    if (oledOk) {
      display.clearDisplay();
      display.setCursor(0, 20);
      display.println("UPDATE SUKSES!");
      display.setCursor(0, 40);
      display.println("Restarting ESP32...");
      display.display();
    }
  });

  ArduinoOTA.onProgress([](unsigned int progress, unsigned int total) {
    static int lastPct = -1;
    unsigned int pct = (total > 0) ? (progress / (total / 100)) : 0;
    if ((int)pct != lastPct && (pct % 5 == 0 || pct == 100)) {
      lastPct = pct;
      Serial.printf("[OTA] Progress: %u%%\r\n", pct);
      if (oledOk) {
        display.clearDisplay();
        display.setTextSize(1);
        display.setCursor(0, 10);
        display.println("UPDATING FIRMWARE");
        display.setCursor(45, 26);
        display.setTextSize(2);
        display.printf("%d%%", pct);
        display.setTextSize(1);
        int w = (pct * 128) / 100;
        display.drawRect(0, 50, 128, 10, SSD1306_WHITE);
        display.fillRect(2, 52, (w > 4 ? w - 4 : 0), 6, SSD1306_WHITE);
        display.display();
      }
    }
  });

  ArduinoOTA.onError([](ota_error_t error) {
    Serial.printf("[OTA] Terjadi Error [%u]: ", error);
    if (error == OTA_AUTH_ERROR) Serial.println("Auth Gagal");
    else if (error == OTA_BEGIN_ERROR) Serial.println("Begin Gagal");
    else if (error == OTA_CONNECT_ERROR) Serial.println("Connect Gagal");
    else if (error == OTA_RECEIVE_ERROR) Serial.println("Receive Gagal");
    else if (error == OTA_END_ERROR) Serial.println("End Gagal");
  });

  ArduinoOTA.begin();
  Serial.println("[OTA] ArduinoOTA siap. Hostname: katrokit-esp32.local");
}

void initWiFiAsync() {
  WiFi.mode(WIFI_STA);
  WiFi.begin(); // Non-blocking: hardware ESP32 mencoba koneksi di background FreeRTOS
  wifiStartTime = millis();
  wifiState = WIFI_CONNECTING;
  apStarted = false;
  Serial.println("[WIFI] Memulai pencarian WiFi tersimpan di background (timeout 15s)...");
}

// Handler pesan MQTT Command (Remote Control)
void mqttCallback(char* topic, byte* payload, unsigned int length) {
  char msg[256];
  if (length >= sizeof(msg)) length = sizeof(msg) - 1;
  memcpy(msg, payload, length);
  msg[length] = '\0';
  Serial.printf("[MQTT CMD] Pesan diterima di [%s]: %s\n", topic, msg);

  JsonDocument doc;
  DeserializationError err = deserializeJson(doc, msg);
  if (err) {
    Serial.println("[MQTT CMD] Gagal parse JSON.");
    return;
  }

  const char* token = doc["token"];
  if (!token || String(token) != secretToken) {
    Serial.println("[MQTT SECURITY] Token salah/tidak sah! Perintah ditolak.");
    return;
  }

  const char* cmd = doc["cmd"];
  if (cmd) {
    if (strcmp(cmd, "tare") == 0) {
      remoteTareReq = true; // Signal ke Core 1 agar dieksekusi secara thread-safe
      Serial.println("[MQTT Core0] Request Remote TARE diterima!");
    } else if (strcmp(cmd, "reset_max") == 0) {
      remoteResetMaxReq = true; // Signal ke Core 1
      Serial.println("[MQTT Core0] Request Reset Fmax diterima!");
    } else if (strcmp(cmd, "set_mode") == 0) {
      int m = doc["mode"] | -1;
      if (m >= 0 && m <= 2) {
        remoteModeReq = m;
        Serial.printf("[MQTT Core0] Request Set Pulley Mode: %d\n", m);
      }
    } else if (strcmp(cmd, "next_mode") == 0) {
      remoteNextModeReq = true;
      Serial.println("[MQTT Core0] Request Next Pulley Mode diterima!");
    } else if (strcmp(cmd, "zero_dist") == 0) {
      remoteZeroDistReq = true;
      Serial.println("[MQTT Core0] Request Zero Distance (distRef) diterima!");
    }
  }
}

// Forward declaration
void publishTelemetry();

// Task Khusus FreeRTOS yang berjalan di Core 0 (PRO_CPU)
// Bertanggung jawab menangani WiFi, Hotspot, ArduinoOTA, dan MQTT HiveMQ
// sehingga Core 1 (Sensor, OLED, Tombol) 100% bebas dari blocking jaringan!
void mqttTask(void *pvParameters) {
  Serial.println("[FreeRTOS Core0] Task Jaringan (WiFi/MQTT/OTA) dimulai di Core 0!");

  mqttClient.setServer(MQTT_BROKER, MQTT_PORT);
  mqttClient.setCallback(mqttCallback);
  mqttClient.setBufferSize(512);

  for (;;) {
    // 1. Cek Koneksi WiFi Awal (15 detik timeout)
    if (wifiState == WIFI_CONNECTING) {
      if (WiFi.status() == WL_CONNECTED) {
        setupOTA();
        otaStarted = true;
        wifiState = WIFI_CONNECTED_NOTIF;
        wifiNotifStart = millis();
        Serial.print("[WIFI Core0] Terhubung ke WiFi! IP: ");
        Serial.println(WiFi.localIP());
      } else if (millis() - wifiStartTime >= 15000) {
        wm.setConfigPortalBlocking(false);
        wm.startConfigPortal("KatroKit-AP");
        apStarted = true;
        wifiState = WIFI_HOTSPOT_NOTIF;
        wifiNotifStart = millis();
        Serial.println("[WIFI Core0] Timeout 15s tercapai. Hotspot 'KatroKit-AP' aktif di background.");
      }
    } else if (wifiState == WIFI_HOTSPOT_NOTIF) {
      if (apStarted) wm.process();
      if (millis() - wifiNotifStart >= 1000) {
        wifiState = WIFI_RUNNING;
        lastDraw = 0;
      }
    } else if (wifiState == WIFI_CONNECTED_NOTIF) {
      if (millis() - wifiNotifStart >= 1000) {
        wifiState = WIFI_RUNNING;
        lastDraw = 0;
      }
    } else { // WIFI_RUNNING
      if (apStarted) {
        wm.process(); // Layani web server portal secara non-blocking di Core 0
      }
      if (WiFi.status() == WL_CONNECTED) {
        if (!otaStarted) {
          setupOTA();
          otaStarted = true;
          wifiState = WIFI_CONNECTED_NOTIF;
          wifiNotifStart = millis();
          Serial.print("[WIFI Core0] Terhubung via Portal! IP: ");
          Serial.println(WiFi.localIP());
        }
        ArduinoOTA.handle(); // Layani OTA di Core 0

        // 2. Layani Koneksi & Streaming MQTT HiveMQ di Core 0
        if (!mqttClient.connected()) {
          unsigned long now = millis();
          if (now - lastMqttReconnect >= 5000) {
            lastMqttReconnect = now;
            Serial.print("[MQTT Core0] Menghubungkan ke HiveMQ... ");
            String clientId = "ESP32_KatroKit_" + String((uint32_t)ESP.getEfuseMac(), HEX);
            if (mqttClient.connect(clientId.c_str())) {
              Serial.println("TERHUBUNG!");
              mqttClient.subscribe(topicCmd.c_str());
              Serial.printf("[MQTT Core0] Subscribed to: %s\n", topicCmd.c_str());
            } else {
              Serial.printf("Gagal (rc=%d). Coba lagi 5s.\n", mqttClient.state());
            }
          }
        } else {
          mqttClient.loop();

          // Kirim telemetri 5 Hz (tiap 200 ms)
          publishTelemetry();
        }
      }
    }

    // Yield ke FreeRTOS scheduler di Core 0 (10 ms)
    vTaskDelay(pdMS_TO_TICKS(10));
  }
}

// Mengirimkan data telemetri ke HiveMQ (5 Hz)
void publishTelemetry() {
  if (!mqttClient.connected()) return;
  unsigned long now = millis();
  if (now - lastMqttPublish < 200) return; // 5 Hz update rate
  lastMqttPublish = now;

  JsonDocument doc;
  doc["token"] = secretToken;
  doc["device_id"] = deviceId;
  doc["mode"] = (int)pulleyMode;
  doc["mode_name"] = PULLEY_NAMES[pulleyMode];
  doc["mode_short"] = PULLEY_SHORT[pulleyMode];
  doc["km_theory"] = serialized(String(PULLEY_KM_THEORY[pulleyMode], 1));
  doc["f"] = serialized(String(force, 2));
  doc["f_sensor"] = serialized(String(fSensor, 2));
  doc["f_max"] = serialized(String(forceMax, 2));
  doc["w_n"] = serialized(String(bebanW, 2));
  doc["w_g"] = serialized(String(bebanGram, 1));
  doc["km"] = serialized(String(km, 2));
  doc["dist"] = serialized(String(distCm, 1));
  doc["dist_ref"] = serialized(String(distRef, 1));
  doc["disp"] = serialized(String(fabs(distCm - distRef), 1));
  doc["work"] = serialized(String(usaha, 2));
  doc["cal"] = isCalibrated;
  doc["raw"] = lastRaw;
  doc["rssi"] = WiFi.RSSI();

  char buffer[448];
  size_t n = serializeJson(doc, buffer);
  mqttClient.publish(topicTelemetry.c_str(), buffer, n);
}

// Cek apakah tombol D4 ditahan saat power-up/boot untuk mereset WiFi
void checkResetWiFiOnBoot() {
  if (digitalRead(BTN) != LOW) return; // Tidak ditekan, lanjut boot normal

  unsigned long startHold = millis();
  const unsigned long holdTarget = 3000; // Wajib tahan selama 3 detik
  bool resetConfirmed = false;

  Serial.println("[BOOT] Tombol D4 terdeteksi ditekan saat power-up. Memulai hitung mundur Reset WiFi...");

  while (digitalRead(BTN) == LOW) {
    unsigned long elapsed = millis() - startHold;
    int progressPct = (elapsed * 100) / holdTarget;
    if (progressPct > 100) progressPct = 100;
    int remainingSec = (int)((holdTarget - elapsed + 999) / 1000);

    if (oledOk) {
      display.clearDisplay();
      display.setTextColor(SSD1306_WHITE);
      display.setTextSize(1);
      display.setCursor(26, 4);
      display.println("RESET WIFI?");
      display.drawFastHLine(0, 16, 128, SSD1306_WHITE);

      display.setCursor(0, 22);
      display.printf("Tahan tombol: %d dtk\n", remainingSec);
      display.setCursor(0, 34);
      display.println("Lepas utk batalkan");

      // Progress bar animasi
      display.drawRect(0, 48, 128, 12, SSD1306_WHITE);
      int barW = (progressPct * 124) / 100;
      display.fillRect(2, 50, barW, 8, SSD1306_WHITE);
      display.display();
    }

    if (elapsed >= holdTarget) {
      resetConfirmed = true;
      break;
    }
    delay(50);
  }

  if (resetConfirmed) {
    Serial.println("[BOOT] 3 detik tercapai! Menghapus kredensial WiFi tersimpan...");
    if (oledOk) {
      display.clearDisplay();
      display.setTextColor(SSD1306_WHITE);
      display.setTextSize(1);
      display.setCursor(20, 10);
      display.println("WIFI DIRESET!");
      display.drawFastHLine(0, 24, 128, SSD1306_WHITE);
      display.setCursor(0, 32);
      display.println("Kredensial Dihapus.");
      display.setCursor(0, 46);
      display.println("Restarting ESP32...");
      display.display();
    }
    delay(1000);

    // Hapus data WiFi dari WiFiManager & Flash NVS
    wm.resetSettings();
    WiFi.disconnect(true, true);
    delay(1000);

    // Tunggu sampai tombol dilepas sebelum reboot agar tidak loop
    while (digitalRead(BTN) == LOW) {
      delay(20);
    }
    delay(200);

    ESP.restart();
  } else {
    Serial.println("[BOOT] Tombol dilepas sebelum 3 detik. Batal reset WiFi, lanjut boot normal.");
  }
}

void setup() {
  Serial.begin(115200);
  Serial.setTimeout(50);
  pinMode(TRIG, OUTPUT);
  pinMode(ECHO, INPUT);
  pinMode(BTN, INPUT_PULLUP);

  Wire.begin(SDA_PIN, SCL_PIN);
  oledOk = display.begin(SSD1306_SWITCHCAPVCC, OLED_ADDR);
  if (!oledOk) {
    Serial.println("OLED tidak terdeteksi! Cek kabel SDA/SCL dan alamat I2C (0x3C/0x3D).");
  }

  // Cek apakah tombol D4 ditahan saat power-up untuk Reset WiFi (Tahan 3s)
  checkResetWiFiOnBoot();

  if (oledOk) {
    display.clearDisplay();
    display.setTextColor(SSD1306_WHITE);
    display.setTextSize(2);
    display.setCursor(10, 10);
    display.println("KatroKit");
    display.setTextSize(1);
    display.setCursor(10, 40);
    display.println("Jangan sentuh tali...");
    display.display();
  }

  // Mulai pencarian WiFi di background secara asinkron (0 ms blocking)
  initWiFiAsync();

  prefs.begin("katrokit", false);
  deviceId = prefs.getString("dev_id", "katrokit_01");
  secretToken = prefs.getString("token", "katrokit2026");
  topicTelemetry = "katrokit/" + deviceId + "/telemetry";
  topicCmd = "katrokit/" + deviceId + "/cmd";

  // Muat mode jenis katrol (0: Tetap, 1: Bebas, 2: Majemuk)
  uint8_t savedMode = prefs.getUChar("pulley_mode", 0);
  if (savedMode > 2) savedMode = 0;
  pulleyMode = (PulleyMode)savedMode;
  Serial.printf("[INIT] Mode Katrol aktif: %s (Teori KM: %.1f)\n", PULLEY_NAMES[pulleyMode], PULLEY_KM_THEORY[pulleyMode]);

  mqttClient.setServer(MQTT_BROKER, MQTT_PORT);
  mqttClient.setCallback(mqttCallback);
  mqttClient.setBufferSize(512);

  calFactor = prefs.getFloat("cal", 1.0f);
  forceSign = prefs.getFloat("sign", -1.0f);
  bebanGram = prefs.getFloat("beban", 240.0f);
  bebanW = (bebanGram / 1000.0f) * G;

  isMultiCal = prefs.getBool("is_multi", false);
  if (isMultiCal) {
    cal1 = prefs.getFloat("cal1", calFactor);
    cal2 = prefs.getFloat("cal2", calFactor);
    midGrams = prefs.getFloat("mid_w", 100.0f);
    midRaw = prefs.getLong("mid_raw", 0);
    isCalibrated = true;
    Serial.printf("[INFO] Mode Kalibrasi: 2-SEGMEN (0 -> %.0fg -> MAX)\n", midGrams);
  } else {
    isCalibrated = (calFactor != 1.0f);
    Serial.printf("[INFO] Mode Kalibrasi: 1-TITIK STANDAR (calFactor = %.2f)\n", calFactor);
  }

  scale.begin(HX_DT, HX_SCK);
  delay(1500);
  if (scale.wait_ready_timeout(2000)) {
    scale.tare(15);
  } else {
    Serial.println("HX711 tidak merespons! Cek DT/SCK, VCC 3.3V dan GND.");
  }

  if (!isCalibrated) {
    showMsg("BELUM KALIBRASI", "Tahan D4 >5 dtk", "utk kalibrasi", 2000);
  }

  for (int i = 0; i < 5; i++) {
    float d = readDistanceCm();
    if (d > 2.0f && d < 250.0f) { distCm = d; distValid = true; }
    delay(60);
  }
  distRef = prefs.getFloat("dist_ref", 3.0f);
  if (distRef < 0.0f || distRef > 250.0f) distRef = 3.0f;
  Serial.printf("[INIT] Referensi Jarak (distRef): %.1f cm\n", distRef);

  // Jalankan Task Jaringan (WiFi/MQTT/OTA) di Core 0 (PRO_CPU)
  // Memastikan Core 1 (Sensor, Tombol, Layar) 100% bebas dari lag jaringan!
  xTaskCreatePinnedToCore(
    mqttTask,
    "mqtt_task",
    8192,
    NULL,
    1,
    &mqttTaskHandle,
    0 // Pinned to Core 0!
  );
}

void loop() {
  // Eksekusi request remote dari web secara thread-safe di Core 1
  if (remoteTareReq) {
    remoteTareReq = false;
    tareForce();
    showMsg("REMOTE TARE (WEB)", "Gaya F = 0 N", "", 1000);
  }
  if (remoteZeroDistReq) {
    remoteZeroDistReq = false;
    zeroDistance(true);
  }
  if (remoteResetMaxReq) {
    remoteResetMaxReq = false;
    forceMax = 0;
  }
  if (remoteModeReq >= 0 && remoteModeReq <= 2) {
    setPulleyMode((PulleyMode)remoteModeReq, true);
    remoteModeReq = -1;
  }
  if (remoteNextModeReq) {
    remoteNextModeReq = false;
    nextPulleyMode();
  }

  handleSerial();

  // Gaya
  if (scale.is_ready()) {
    lastRaw = scale.get_value(1);
    fSensor = rawToNewtons((float)lastRaw);
    if (fSensor < 0.0f) fSensor = 0.0f;

    // Perhitungan Gaya Kuasa F sesuai Mode Katrol:
    // - Mode Tetap: Load cell menahan poros katrol (W + F = 2F), maka F_kuasa = fSensor / 2.0f
    // - Mode Bebas & Majemuk: Load cell menahan 1 helai tali jangkar, maka F_kuasa = fSensor
    float fInstant = (pulleyMode == MODE_TETAP) ? (fSensor / 2.0f) : fSensor;
    if (fInstant < 0.0f) fInstant = 0.0f;
    fBuf[fIdx] = fInstant;
    fIdx++;
    if (fIdx >= F_N) { fIdx = 0; fFull = true; }
    force = avgBuf(fBuf, F_N, fFull, fIdx);
    if (fabs(force) < 0.05f) force = 0.0f;
    if (force > forceMax) forceMax = force;

    float disp_m = fabs(distCm - distRef) / 100.0f;
    usaha = (force > 0 ? force : 0) * disp_m;

    if (isCalibrated && force >= 0.30f) {
      km = bebanW / force;
      if (km > 10.0f) km = 10.0f;
    } else {
      km = 0.0f;
    }
  }

  // Jarak tiap 100 ms
  if (millis() - lastDist >= 100) {
    lastDist = millis();
    float d = readDistanceCm();
    if (d > 2.0f && d < 250.0f) {
      dBuf[dIdx] = d;
      dIdx++;
      if (dIdx >= D_N) { dIdx = 0; dFull = true; }
      distCm = avgBuf(dBuf, D_N, dFull, dIdx);
      distValid = true;
    }
  }

  // Tombol: aksi ditentukan lama tahan, dijalankan saat DILEPAS
  bool pressed = (digitalRead(BTN) == LOW);
  if (pressed && !btnDown) {
    btnDown = true;
    btnDownAt = millis();
  } else if (!pressed && btnDown) {
    btnDown = false;
    unsigned long held = millis() - btnDownAt;
    if (held >= 50) { // abaikan bouncing
      if (held >= T_WEIGH) {
        // Tahan lama: batalkan deteksi multi-click
        waitingForMultiClick = false;
        clickCount = 0;
        if (held < T_PRESET)      weighLoad();
        else if (held < T_CAL)   nextPreset();
        else                     calibrateMultiOLED(); // Tahan > 5 detik: Wizard Kalibrasi
      } else {
        // Klik singkat (< 1.5 detik)
        clickCount++;
        lastClickReleaseAt = millis();
        if (clickCount >= 3) {
          // TRIPLE CLICK TERDETEKSI! (Nol-kan referensi jarak distRef)
          waitingForMultiClick = false;
          clickCount = 0;
          zeroDistance(true);
        } else {
          waitingForMultiClick = true; // Tunggu kemungkinan klik berikutnya (1x -> 2x -> 3x)
        }
      }
    }
    lastDraw = millis();
  }

  // Timeout multi-click: jalankan aksi 1x (Tare Gaya) atau 2x (Ganti Mode)
  // Pastikan !btnDown agar tidak terpotong saat user sedang menekan klik berikutnya
  if (waitingForMultiClick && !btnDown && (millis() - lastClickReleaseAt >= MULTI_CLICK_WINDOW_MS)) {
    int clicks = clickCount;
    waitingForMultiClick = false;
    clickCount = 0;
    if (clicks == 1) {
      tareForce();
      showMsg("TARE OK", "Gaya F = 0 N", "", 700);
    } else if (clicks == 2) {
      nextPulleyMode(); // Ganti Mode Katrol (Tetap -> Bebas -> Majemuk)
    }
    lastDraw = millis();
  }

  // OLED + Serial Plotter tiap 100 ms
  if (wifiState == WIFI_HOTSPOT_NOTIF) {
    // Popup notifikasi Hotspot aktif tepat selama 1 detik
    if (oledOk) {
      display.clearDisplay();
      display.setTextColor(SSD1306_WHITE);
      display.setTextSize(1);
      display.setCursor(18, 6);
      display.println("HOTSPOT AKTIF");
      display.drawFastHLine(0, 18, 128, SSD1306_WHITE);
      display.setCursor(0, 26);
      display.println("AP: KatroKit-AP");
      display.setCursor(0, 42);
      display.println("IP: 192.168.4.1");
      display.display();
    }
  } else if (wifiState == WIFI_CONNECTED_NOTIF) {
    // Popup notifikasi WiFi terhubung tepat selama 1 detik
    if (oledOk) {
      display.clearDisplay();
      display.setTextColor(SSD1306_WHITE);
      display.setTextSize(1);
      display.setCursor(14, 6);
      display.println("WIFI TERHUBUNG");
      display.drawFastHLine(0, 18, 128, SSD1306_WHITE);
      display.setCursor(0, 26);
      display.println(WiFi.SSID());
      display.setCursor(0, 42);
      display.println(WiFi.localIP().toString());
      display.display();
    }
  } else if (millis() - lastDraw >= 100) {
    lastDraw = millis();
    if (btnDown) drawHold(millis() - btnDownAt);
    else draw();
    Serial.print("Gaya_N:");
    Serial.print(force, 2);
    Serial.print(",RAW:");
    Serial.print(lastRaw);
    Serial.print(",KM:");
    Serial.print(km, 2);
    Serial.print(",Mode:");
    Serial.print(PULLEY_SHORT[pulleyMode]);
    Serial.print(",Jarak_cm:");
    Serial.print(distCm, 1);
    Serial.print(",Pindah_cm:");
    Serial.println(distCm - distRef, 1);
  }
}
