syahrilTGR/KatroKit_esp32/(commit log)

2026-11-03 chore: initialize PlatformIO project configuration for ESP32 DevKit
2026-11-03 feat(firmware): add KatroKit v2 ESP32 firmware with external button on GPIO 4
2026-11-03 docs(hardware): add 120x80x50mm acrylic box design, PCB matrix wiring, and schematics
    [acrylic_box_cutting.dxf]
2026-11-03 feat(casing): add HC-SR04 acrylic enclosure cutting templates and assembly guide
    [hcsr04_casing_cutting.dxf]
2026-11-03 docs(hardware): update HC-SR04 and HX711 connector pinouts
2026-11-04 docs: update acrylic box cutting designs from affinity designer
    [acrylic_box_cutting.dxf]
2026-11-04 feat(ota): integrate WiFiManager captive portal and ArduinoOTA for main and test code
2026-11-04 feat(calibration): integrate 2-segment multi-point calibration wizard to button D4 (>5s hold)
2026-11-05 feat: add hold-on-boot WiFi reset, Arduino IDE .ino sketch, and library guide
    [KatroKit_esp32.ino, main.cpp]
2026-11-05 style(docs): format EOF newline in arduino_ide_guide.md
2026-11-09 feat: add double-click pulley mode selection (tetap, bebas, majemuk) with nvs persistence and web dashboard support
2026-11-09 refactor: simplify pulley mode to dual-mode (tetap and majemuk toggle)
2026-11-12 Revert "refactor: simplify pulley mode to dual-mode (tetap and majemuk toggle)"
    This reverts commit 4826a71e28ceafa7eb5b3cf67bd9e418c678cb92.
    [KatroKit_esp32.ino, main.cpp]
2026-11-14 feat(web): add Set Jarak 0 button and real-time distRef display
2026-11-14 docs: update button guide, physics formulas, and MQTT payload for distRef
